ATM-HSW/CombiSensor/README.md

# CombiSensor
MCU plattform + Sensor module for several environmental sensors + LoRaWAN
