ATM-HSW/CombiSensor/Hardware/SensorBoard/SensorsOnly.v7.brd.pdf

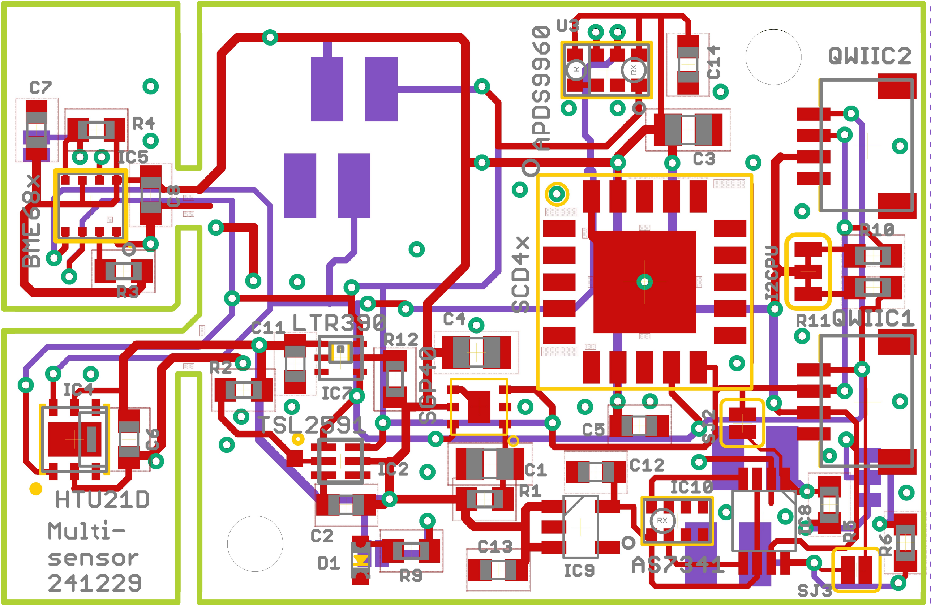
[picture p1: figure]

08.02.2025 20:13 f=5.74 C:\Clouds\CS2_CAD\eagle\RaumSensor\SensorsOnly\v7\SensorsOnly.v7.brd
