ATM-HSW/CombiSensor/Hardware/BaseBoard-Feather/feather.v4.brd.pdf

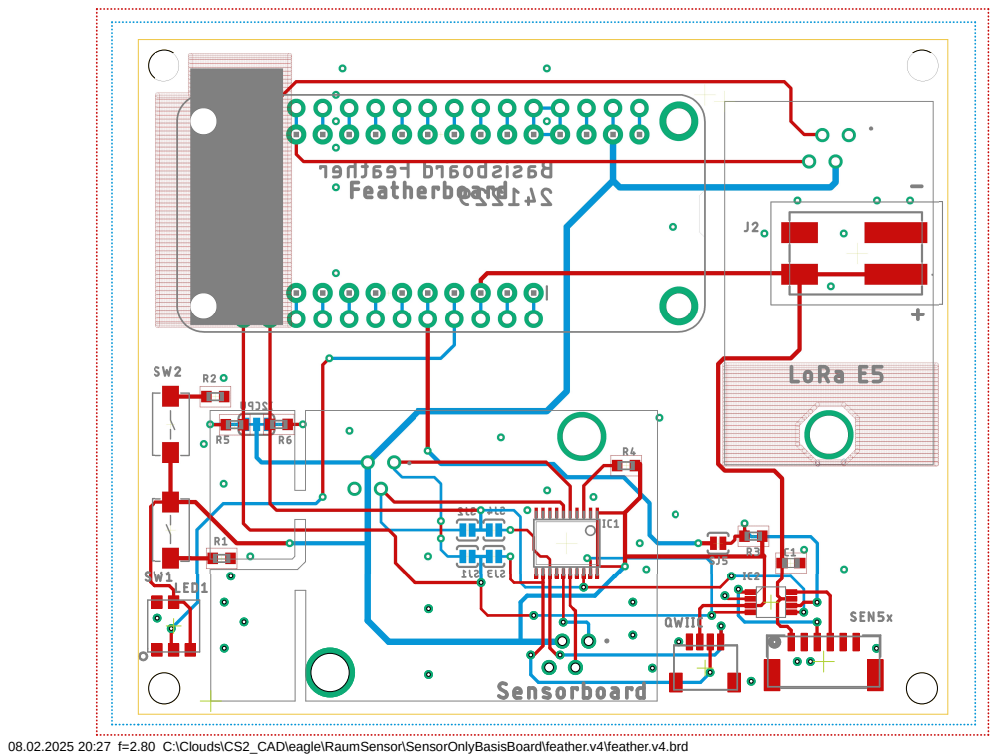
[picture p2: page 1]

08.02.2025 20:27 f=2.80 C:\Clouds\CS2_CAD\eagle\RaumSensor\SensorOnlyBasisBoard\feather.v4\feather.v4.brd
