ATM-HSW/CombiSensor/Hardware/BaseBoard-Feather/feather.v4.sch.pdf

# SensorBoard Feather

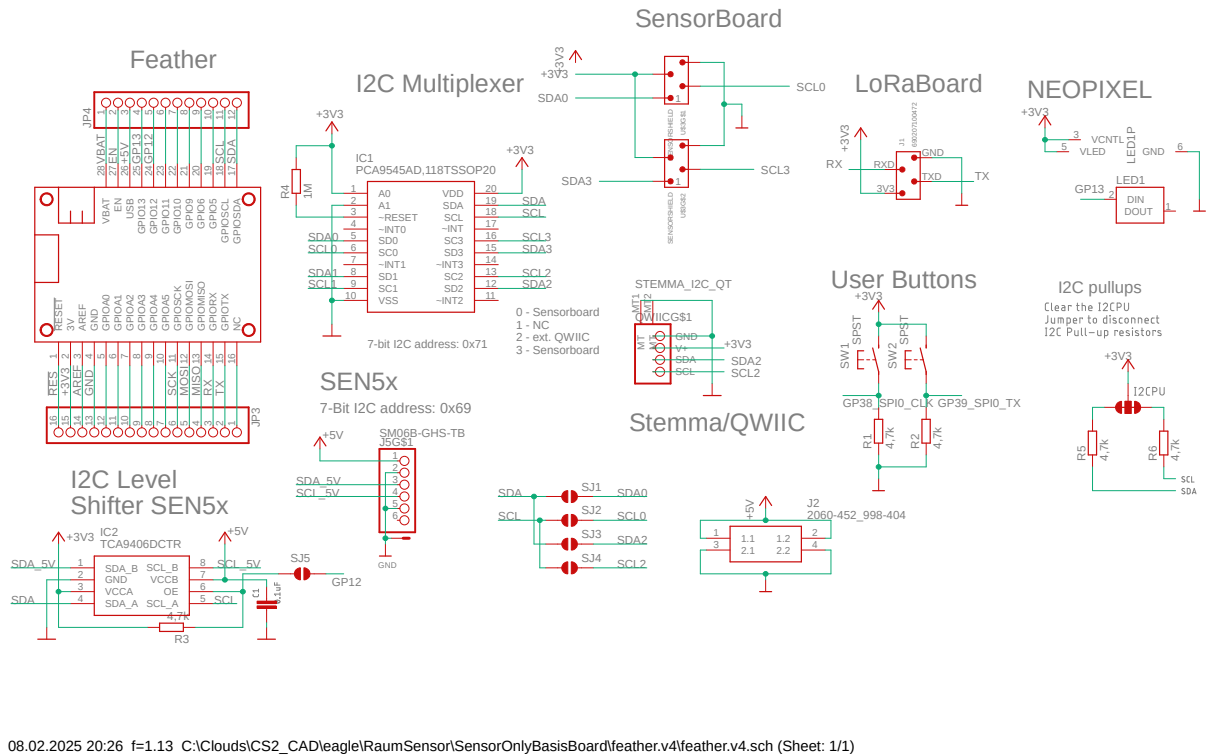
[picture p3: page 1]
User Buttons; Stemma/QWIIC; 7-bit I2C address: 0x71; I2C Multiplexer; 0 - Sensorboard 1 - NC 2 - ext. QWIIC 3 - Sensorboard; NEOPIXEL; I2C pullups; LoRaBoard; SEN5x; I2C Level Shifter SEN5x; 7-Bit I2C address: 0x69; +3V3 SPST; SPST 4,7k; PCA9545AD,118TSSOP20 1M; +3V3 ⁶⁹⁰²⁰⁷¹⁰⁰⁴⁷² SENSORSHIELD SENSORSHIELD +3V³; SM06B-GHS-TB GND +5V; TCA9406DCTR; GND V+ SDA SCL; DIN 2; DOUT; LED1; VLED 5; GND 6 VCNTL 3; LED¹P SW¹; SW² R¹; A0 1 A1 2 ~RESET 3 ~INT0 4 SD0 5 SC0 6 ~INT1 7 SD1 8 SC1 9; VSS 10; ~INT2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

9 GPIOA5 10 GPIOSCK 11 GPIOMOSI 12 GPIOMISO 13 GPIORX 14 GPIOTX 15 NC 16 GPIOSDA 17 GPIOSCL 18 GPIO5 19 GPIO9 21 GPIO6 20 GPIO10 22 GPIO11 23 GPIO12 24 GPIO13 25 EN 27 USB 26 VBAT 28 16151413121110

STEMMA_I2C_QT
QWIICG$1 MT MT1 MT MT2

08.02.2025 20:26 f=1.13 C:\Clouds\CS2_CAD\eagle\RaumSensor\SensorOnlyBasisBoard\feather.v4\feather.v4.sch (Sheet: 1/1)
