ATM-HSW/CombiSensor/Hardware/BaseBoard-QTPy/QTPY.v3.brd.pdf

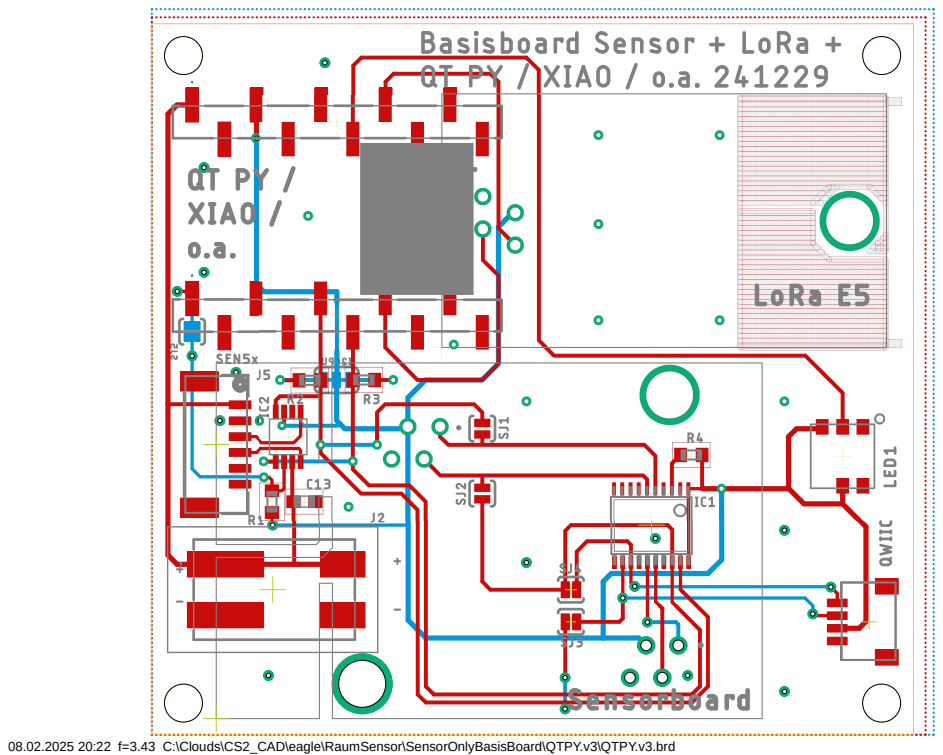
[picture p4: page 1]

08.02.2025 20:22 f=3.43 C:\Clouds\CS2_CAD\eagle\RaumSensor\SensorOnlyBasisBoard\QTPY.v3\QTPY.v3.brd
