ATM-HSW/CombiSensor/Hardware/BaseBoard-QTPy/QTPY.v3.sch.pdf

# QT PY

# I2C Level

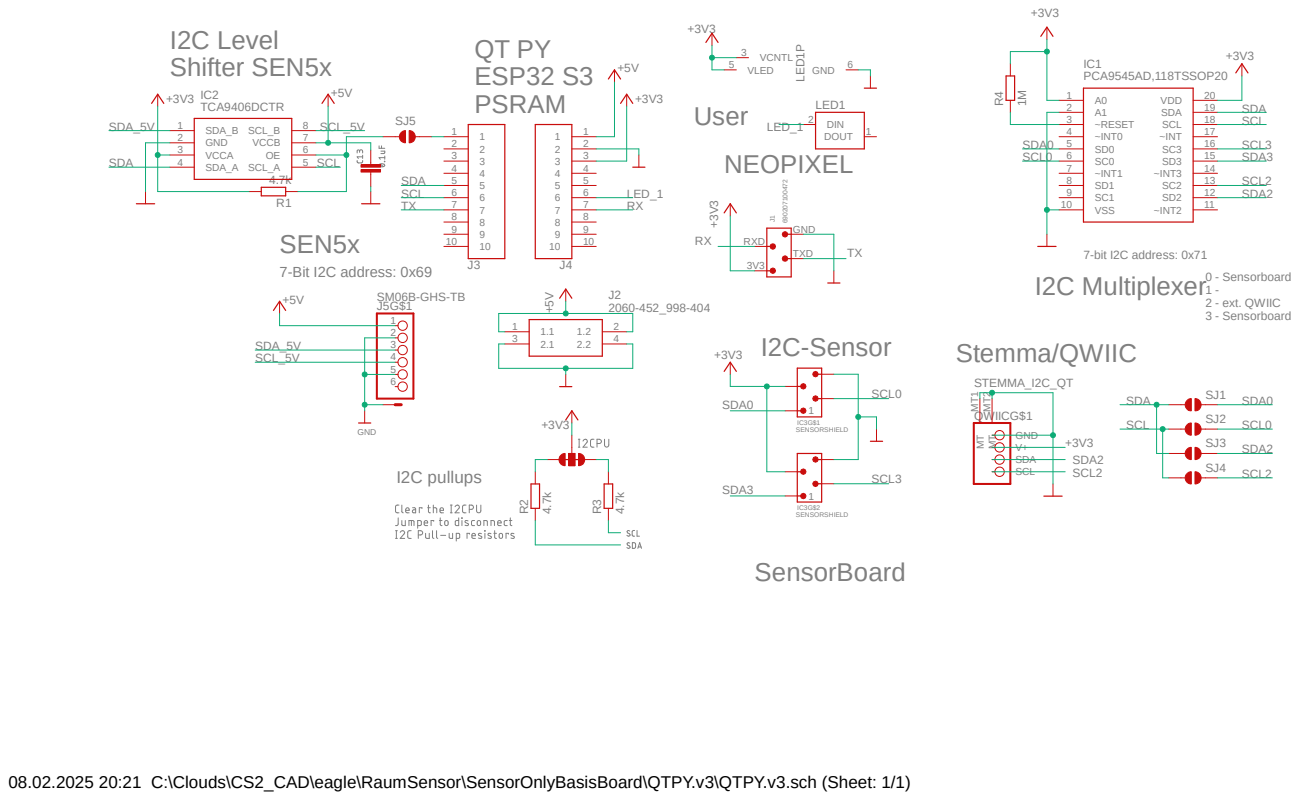
[picture p5: page 1]
SensorBoard; User; Stemma/QWIIC; ESP32 S3 PSRAM; 7-bit I2C address: 0x71 I2C Multiplexer⁰ ⁻ Sensorboard 1 - 2 - ext. QWIIC 3 - Sensorboard; NEOPIXEL; I2C pullups; I2C-Sensor; Shifter SEN5x; SEN5x; 7-Bit I2C address: 0x69; PCA9545AD,118TSSOP20 1M 4.7k; SENSORSHIELD; SENSORSHIELD +3V3 ⁺³V³ +5V; SM06B-GHS-TB; GND +5V; TCA9406DCTR; GND V+ SDA; DIN 2; DOUT; 1 LED1; VLED 5; GND 6; VCNTL 3; LED¹P; A0 1 A1 2 ~RESET 3 ~INT0 4 SD0 5 SC0 6 ~INT1 7 SD1 8 SC1 9; VSS 10; ~INT2; 13 ~INT3; 16 ~INT; 17 SCL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

STEMMA_I2C_QT
SCL QWIICG$1 MT MT1 MT MT2

08.02.2025 20:21 C:\Clouds\CS2_CAD\eagle\RaumSensor\SensorOnlyBasisBoard\QTPY.v3\QTPY.v3.sch (Sheet: 1/1)
