ATM-HSW/CombiSensor/Hardware/BaseBoard-WaveshareESP32S2-LCD/waveshare.v4.brd.pdf

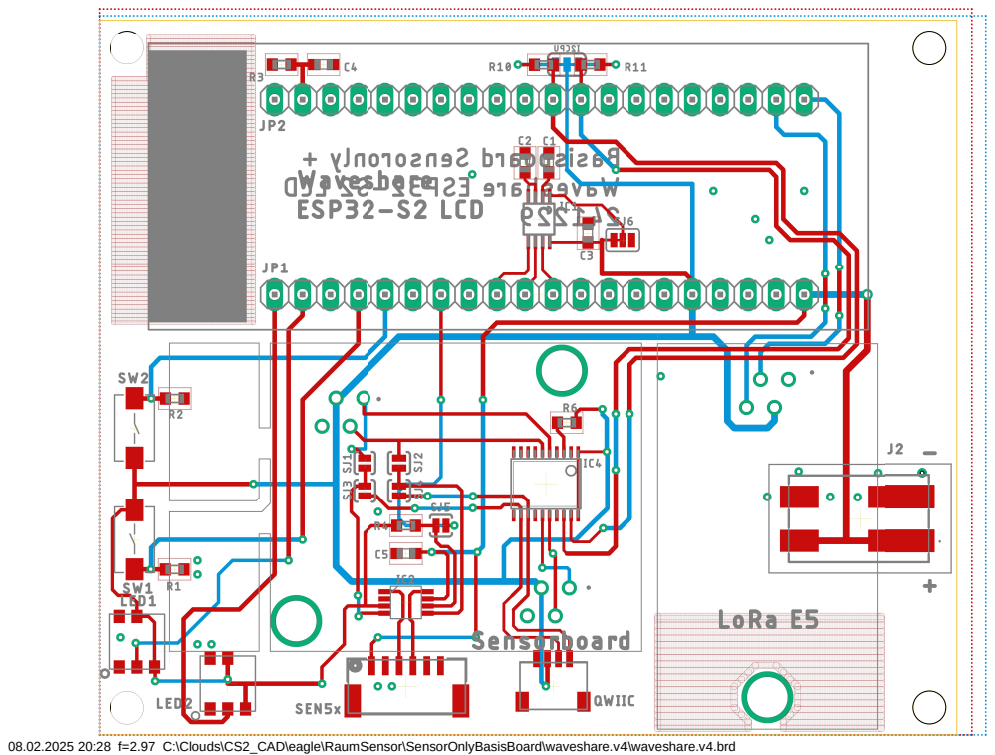
[picture p6: page 1]

08.02.2025 20:28 f=2.97 C:\Clouds\CS2_CAD\eagle\RaumSensor\SensorOnlyBasisBoard\waveshare.v4\waveshare.v4.brd
