ATM-HSW/CombiSensor/Hardware/BaseBoard-WaveshareESP32S2-LCD/waveshare.v4.sch.pdf

# I2C Multiplexer

# SEN5x

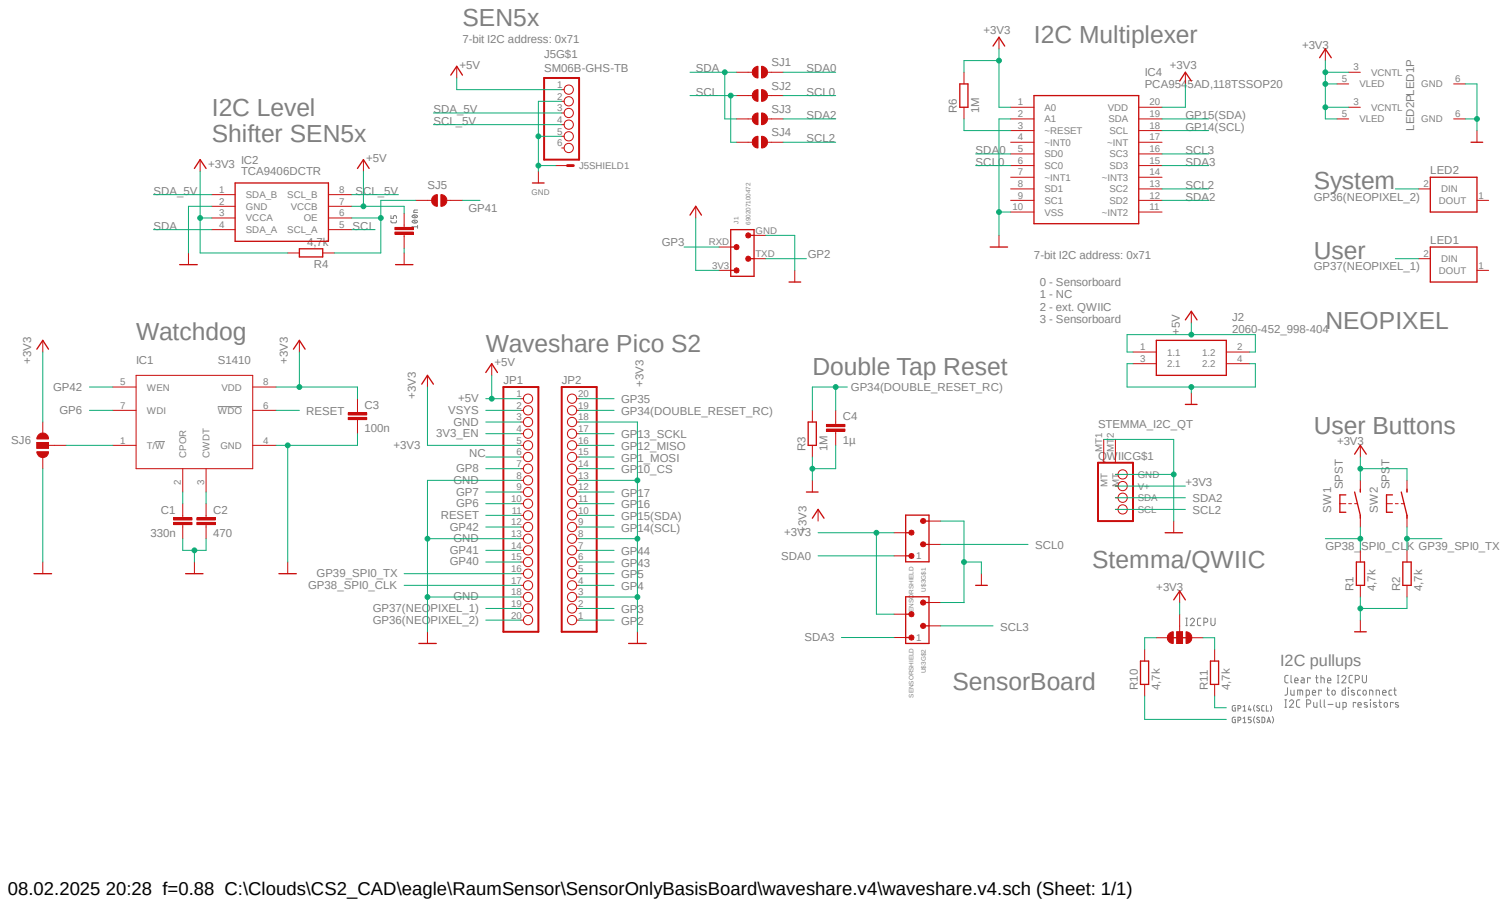
[picture p7: page 1]

08.02.2025 20:28 f=0.88 C:\Clouds\CS2_CAD\eagle\RaumSensor\SensorOnlyBasisBoard\waveshare.v4\waveshare.v4.sch (Sheet: 1/1)
