ATM-HSW/CombiSensor/Hardware/SensorBoard/SensorsOnly.v7.sch.pdf

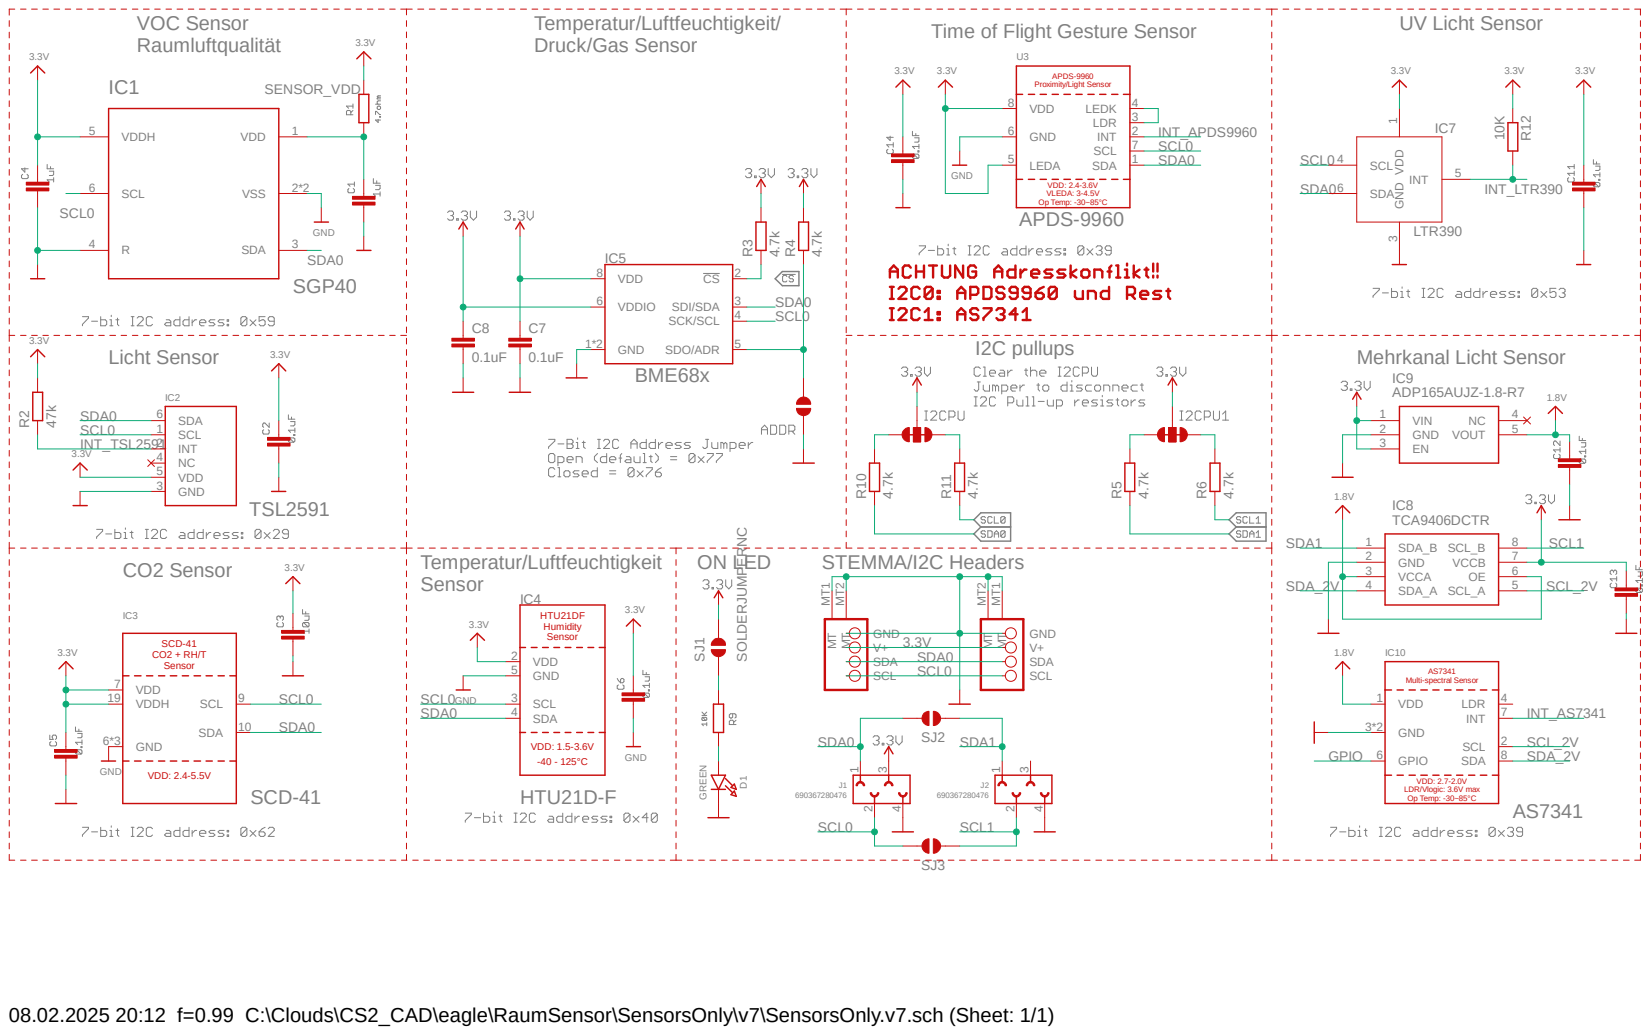
[picture p8: page 1]

Time of Flight Gesture Sensor

08.02.2025 20:12 f=0.99 C:\Clouds\CS2_CAD\eagle\RaumSensor\SensorsOnly\v7\SensorsOnly.v7.sch (Sheet: 1/1)
