ATM-HSW/CombiSensor/Hardware/SensorBoard/SensorsOnly.v6.brd.pdf

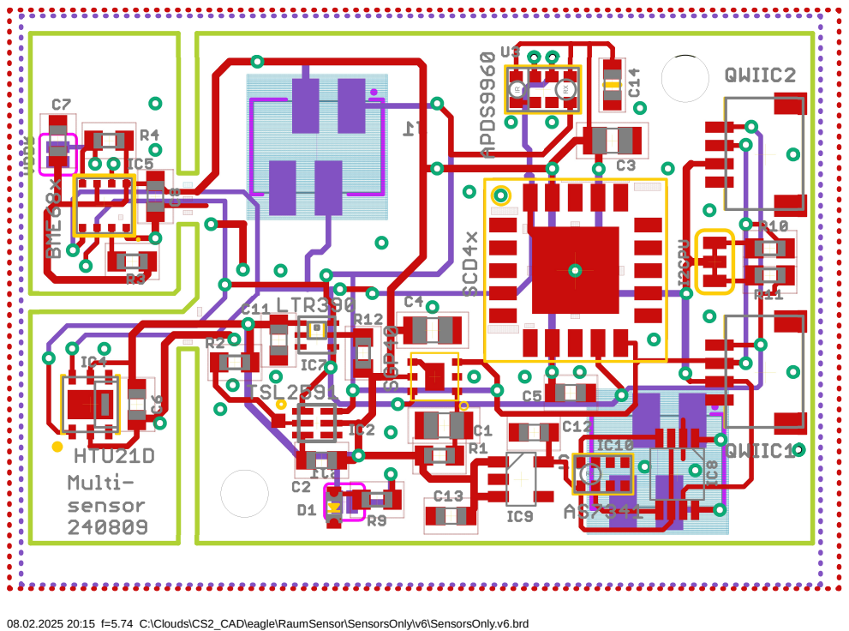
[picture p9: page 1]

08.02.2025 20:15 f=5.74 C:\Clouds\CS2_CAD\eagle\RaumSensor\SensorsOnly\v6\SensorsOnly.v6.brd
