ATM-HSW/CombiSensor/Hardware/SensorBoard/SensorsOnly.v6.sch.pdf

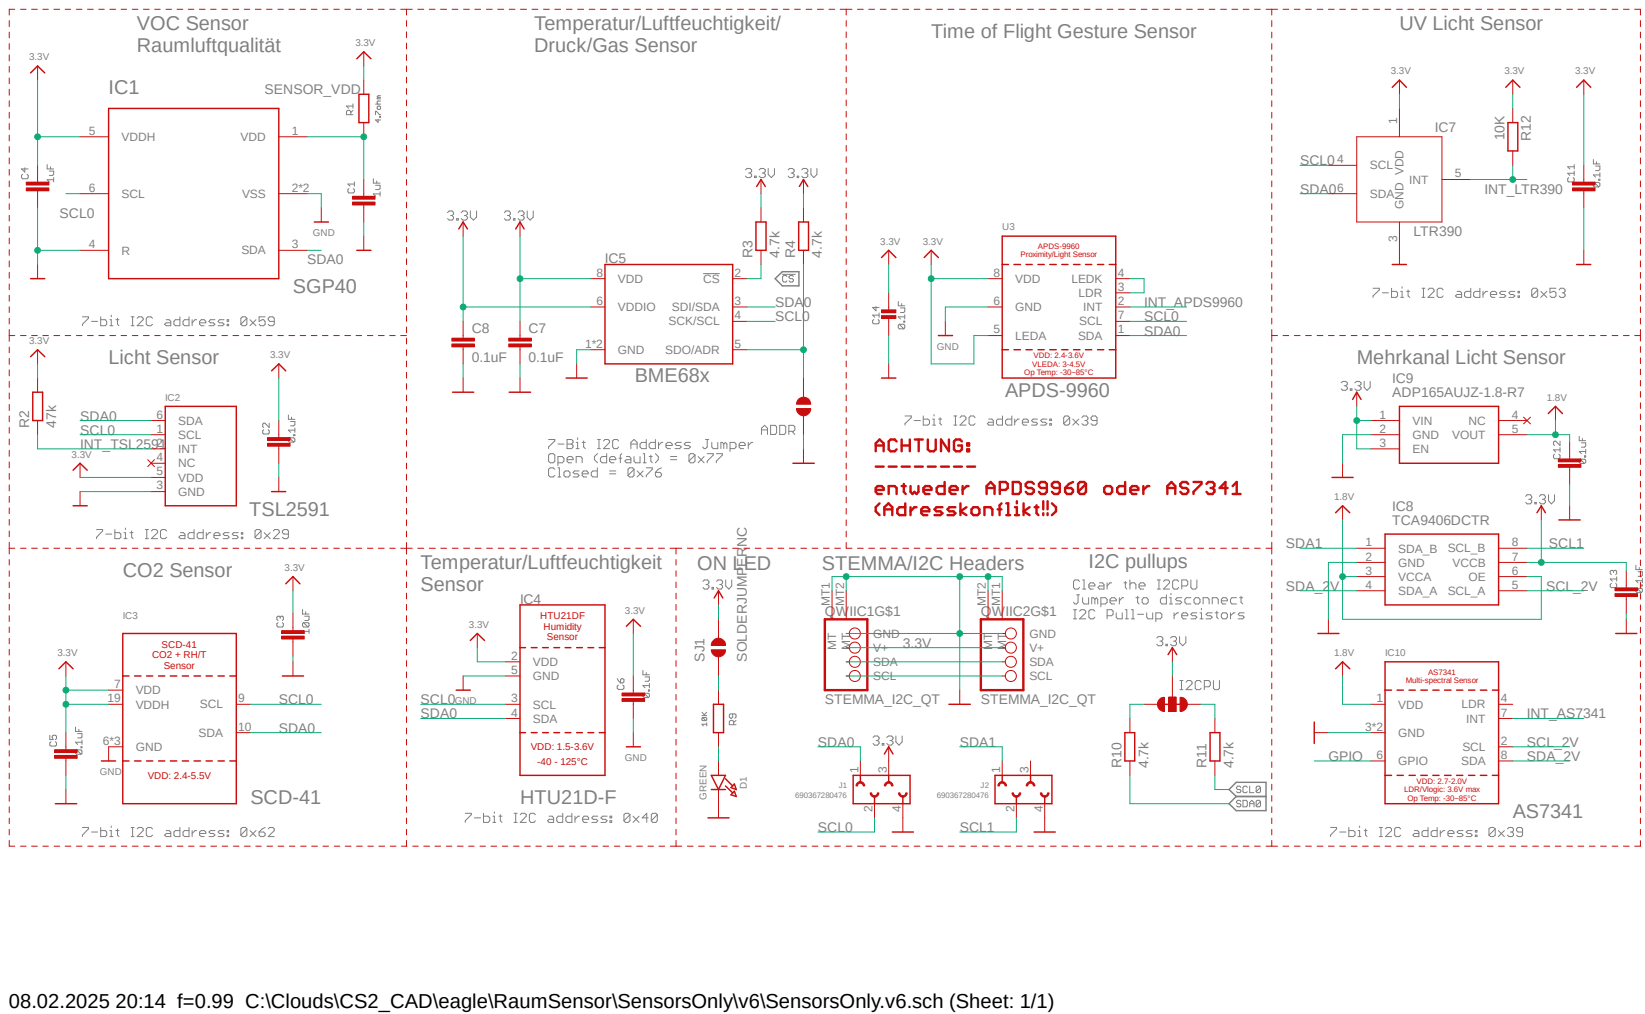
[picture p10: page 1]

Time of Flight Gesture Sensor

08.02.2025 20:14 f=0.99 C:\Clouds\CS2_CAD\eagle\RaumSensor\SensorsOnly\v6\SensorsOnly.v6.sch (Sheet: 1/1)
