ATM-HSW/CombiSensor/Hardware/SensorBoard/SensorsOnly.v6.brd

## EAGLE design Hardware/SensorBoard/SensorsOnly.v6.brd (2025-03-10, an earlier design)

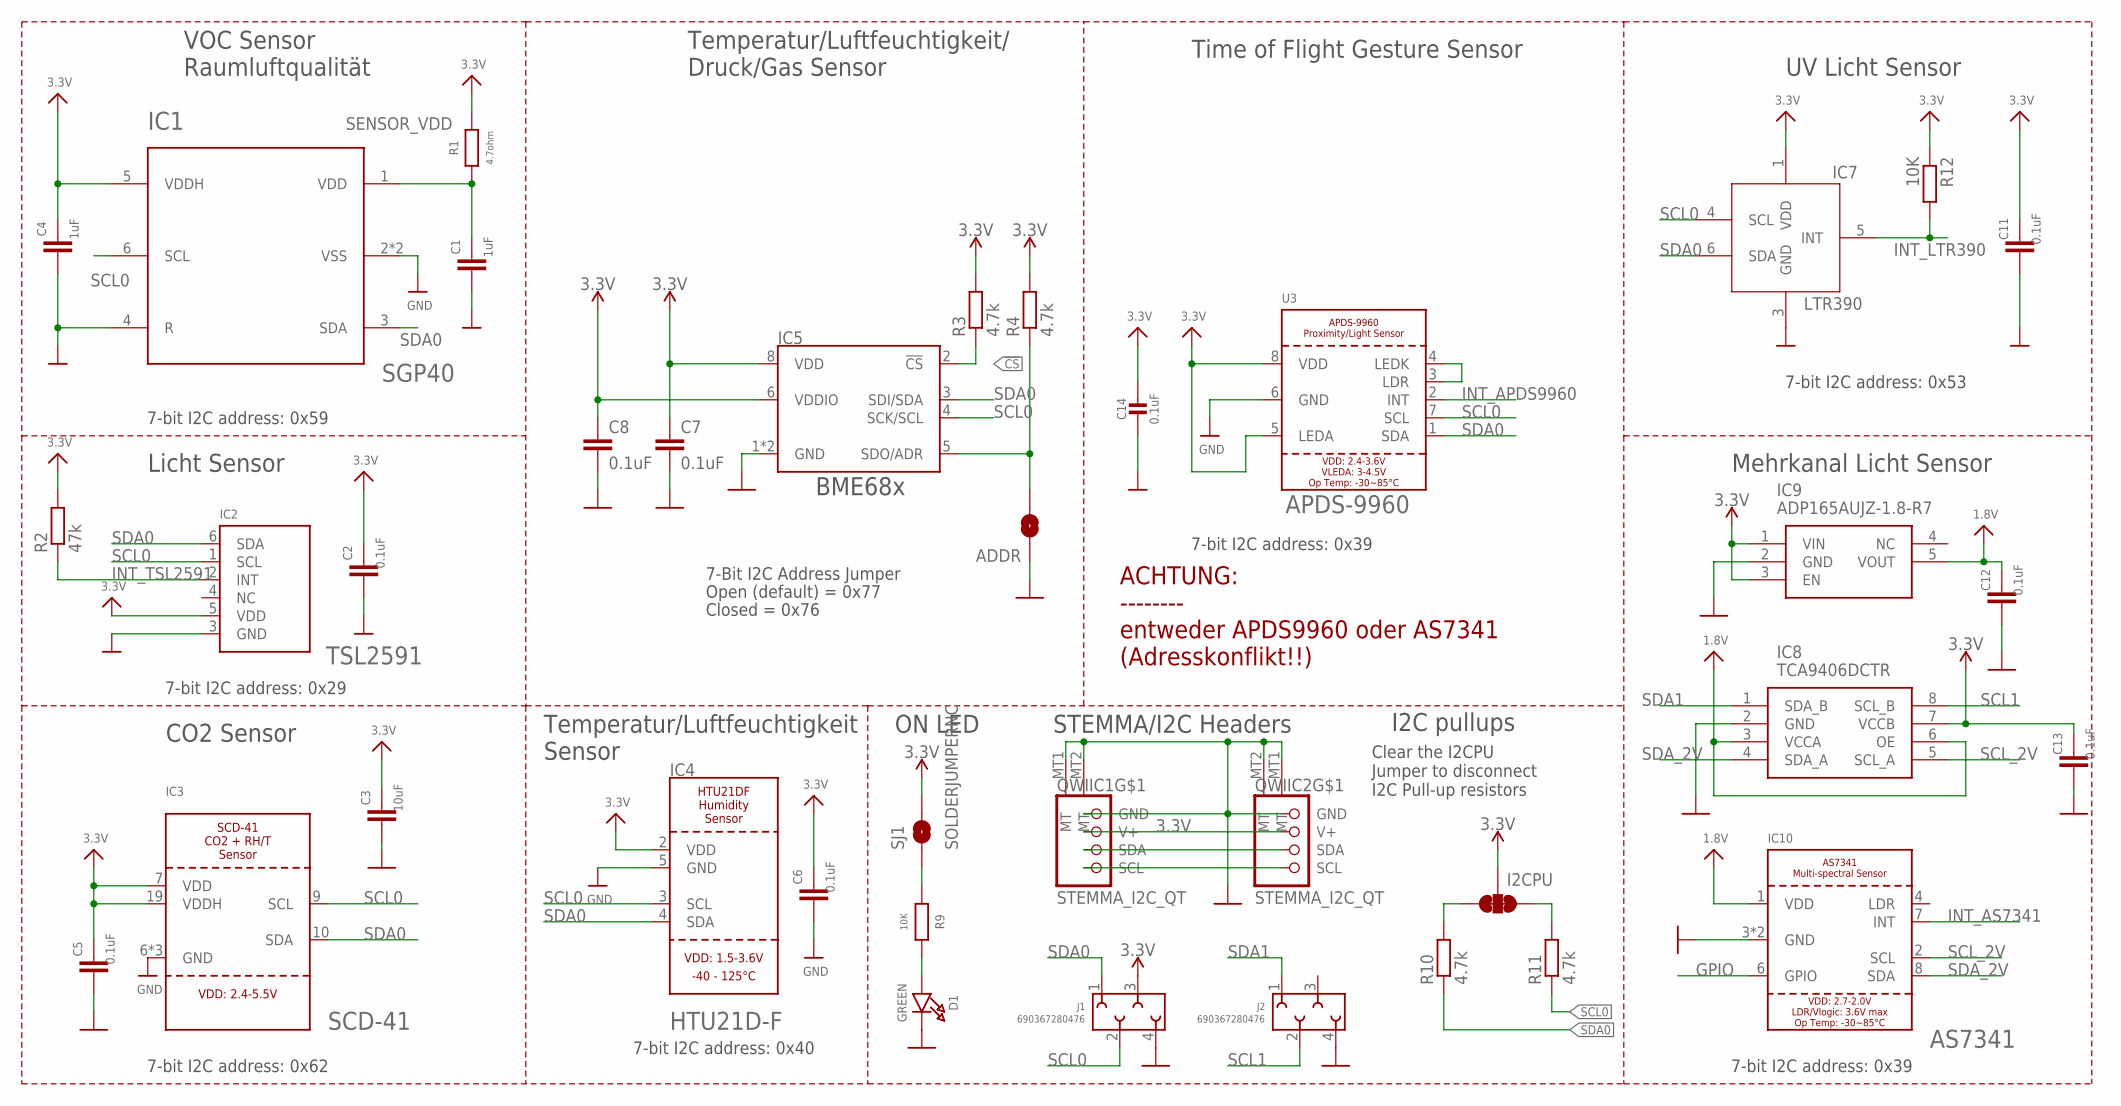
[picture p11: schematic SensorsOnly.v6.sch]

Parts:
ADDR: JUMPER-SMT_2_NO_SILK; SMT-JUMPER_2_NO_SILK
C1, C4: 1uF; C0805
C2, C5, C6, C7, C8, C11, C12, C13: 0.1uF; C0603
C3: 10uF; C0805
C14: 0.1uF; 0603-NO
D1: GREEN; CHIPLED_0603_NOOUTLINE
I2CPU: I2C PU; SMT-JUMPER_3_2-NC_TRACE_SILK
IC1: SGP40; SGP30
IC2: TSL2591; DFN6_TAOS
IC3: SCD-41; SCD41
IC4: HTU21D-F; HTU21DF
IC5: BME680 Air Quality Sensor; LGA3.0X3.0
IC7: LTR390
IC8: TCA9406DCTR; SOP65P400X130-8N
IC9: ADP165AUJZ-1.8-R7; SOT95P280X100-5N
IC10: AS7341
J1, J2: 690367280476
QWIIC1, QWIIC2: STEMMA_I2C_QT; JST_SH4
R1: 4.7ohm; R0603
R2: 47k; R0603
R3, R4, R10, R11: 4.7k; R0603
R9, R12: 10K; R0603
SJ1: SOLDERJUMPERNC; SJ_2S
U3: APDS-9960

Connections:
1.8V: C12.1, IC8.3 (VCCA), IC8.6 (OE), IC9.5 (VOUT), IC10.1 (VDD)
3.3V: C2.1, C3.1, C4.1, C5.1, C6.1, C7.1, C8.1, C11.1, C13.1, C14.1, I2CPU.2, IC1.5 (VDDH), IC2.5 (VDD), IC3.7 (VDD), IC3.19 (VDDH), IC4.2 (VDD), IC5.6 (VDDIO), IC5.8 (VDD), IC7.1 (VDD), IC8.7 (VCCB), IC9.1 (VIN), IC9.3 (EN), J1.3, QWIIC1.2 (V+), QWIIC2.2 (V+), R1.2, R2.2, R3.2, R4.2, R12.1, SJ1.2, U3.5 (LEDA), U3.8 (VDD)
!CS: IC5.2 (!CS), R3.1
GND: ADDR.1, C1.2, C2.2, C3.2, C4.2, C5.2, C6.2, C7.2, C8.2, C11.2, C12.2, C13.2, C14.2, D1.C, IC1.2 (VSS), IC1.4 (R), IC1.P$7 (VSS), IC2.3 (GND), IC3.6 (GND), IC3.20 (GND), IC3.P$1 (GND), IC4.5 (GND), IC5.1 (GND), IC5.7 (GND), IC7.3 (GND), IC8.2 (GND), IC9.2 (GND), IC10.3 (GND), IC10.5 (GND), J1.4, J2.4, QWIIC1.1 (GND), QWIIC1.MT1 (MT), QWIIC1.MT2 (MT), QWIIC2.1 (GND), QWIIC2.MT1 (MT), QWIIC2.MT2 (MT), U3.6 (GND)
GPIO: IC10.6 (GPIO)
INT_APDS9960: U3.2 (INT)
INT_AS7341: IC10.7 (INT)
INT_LTR390: IC7.5 (INT), R12.2
INT_TSL2591: IC2.2 (INT), R2.1
unnamed: D1.A, R9.2
unnamed: U3.3 (LDR), U3.4 (LEDK)
unnamed: R9.1, SJ1.1
unnamed: I2CPU.3, R10.2
unnamed: I2CPU.1, R11.2
SCL0: IC1.6 (SCL), IC2.1 (SCL), IC3.9 (SCL), IC4.3 (SCL), IC5.4 (SCK/SCL), IC7.4 (SCL), J1.2, QWIIC1.4 (SCL), QWIIC2.4 (SCL), R11.1, U3.7 (SCL)
SCL1: IC8.8 (SCL_B), J2.2
SCL_2V: IC8.5 (SCL_A), IC10.2 (SCL)
SDA0: IC1.3 (SDA), IC2.6 (SDA), IC3.10 (SDA), IC4.4 (SDA), IC5.3 (SDI/SDA), IC7.6 (SDA), J1.1, QWIIC1.3 (SDA), QWIIC2.3 (SDA), R10.1, U3.1 (SDA)
SDA1: IC8.1 (SDA_B), J2.1
SDA_2V: IC8.4 (SDA_A), IC10.8 (SDA)
SDO/ADR: ADDR.2, IC5.5 (SDO/ADR), R4.1
SENSOR_VDD: C1.1, IC1.1 (VDD), R1.1

Notes on the sheet:
STEMMA/I2C Headers
ON LED
7-Bit I2C Address Jumper
Open (default) = 0x77
Closed = 0x76
Clear the I2CPU Jumper to disconnect I2C Pull-up resistors
7-bit I2C address: 0x39
Time of Flight Gesture Sensor
I2C pullups
7-bit I2C address: 0x40
7-bit I2C address: 0x62
7-bit I2C address: 0x29
7-bit I2C address: 0x59
7-bit I2C address: 0x53
ACHTUNG: -------- entweder APDS9960 oder AS7341 (Adresskonflikt!!)
VOC Sensor Raumluftqualität
Temperatur/Luftfeuchtigkeit/ Druck/Gas Sensor
UV Licht Sensor
Mehrkanal Licht Sensor
Temperatur/Luftfeuchtigkeit Sensor
CO2 Sensor
Licht Sensor
BME68x

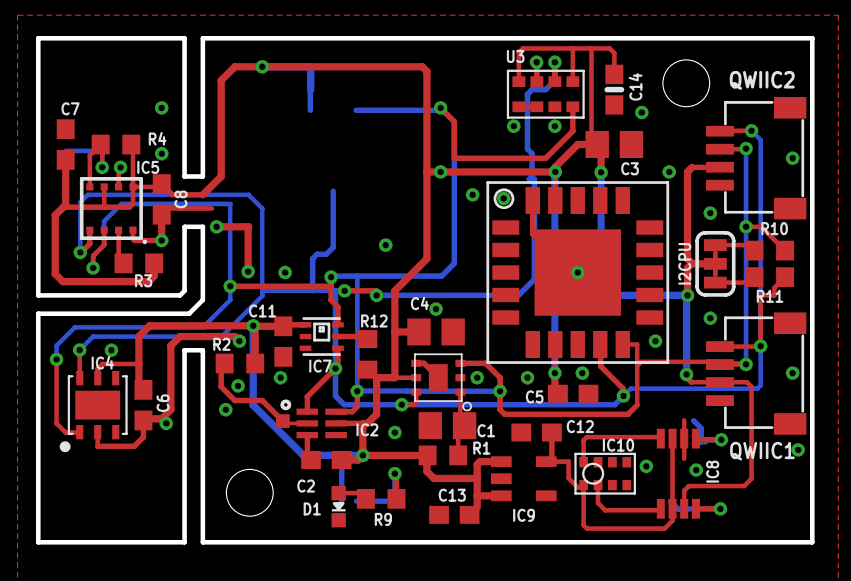
[picture p12: board SensorsOnly.v6.brd from above]

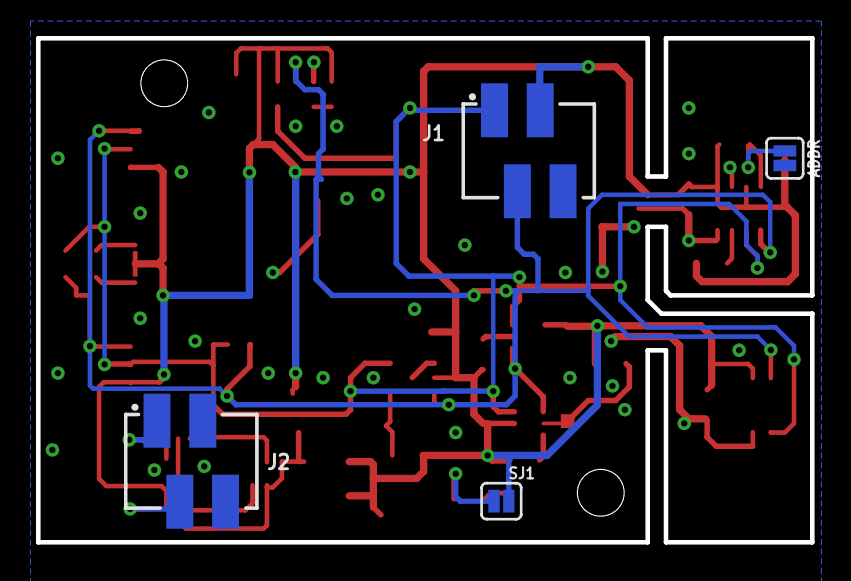
[picture p13: board SensorsOnly.v6.brd from below]

Board: 2 copper layers, 43.0 x 28.0 mm, 38 parts (4 on the bottom side), 19 nets.
