ATM-HSW/CombiSensor/Hardware/BaseBoard-QTPy/QTPY.v3.brd

## EAGLE design Hardware/BaseBoard-QTPy/QTPY.v3.brd (2025-03-10)

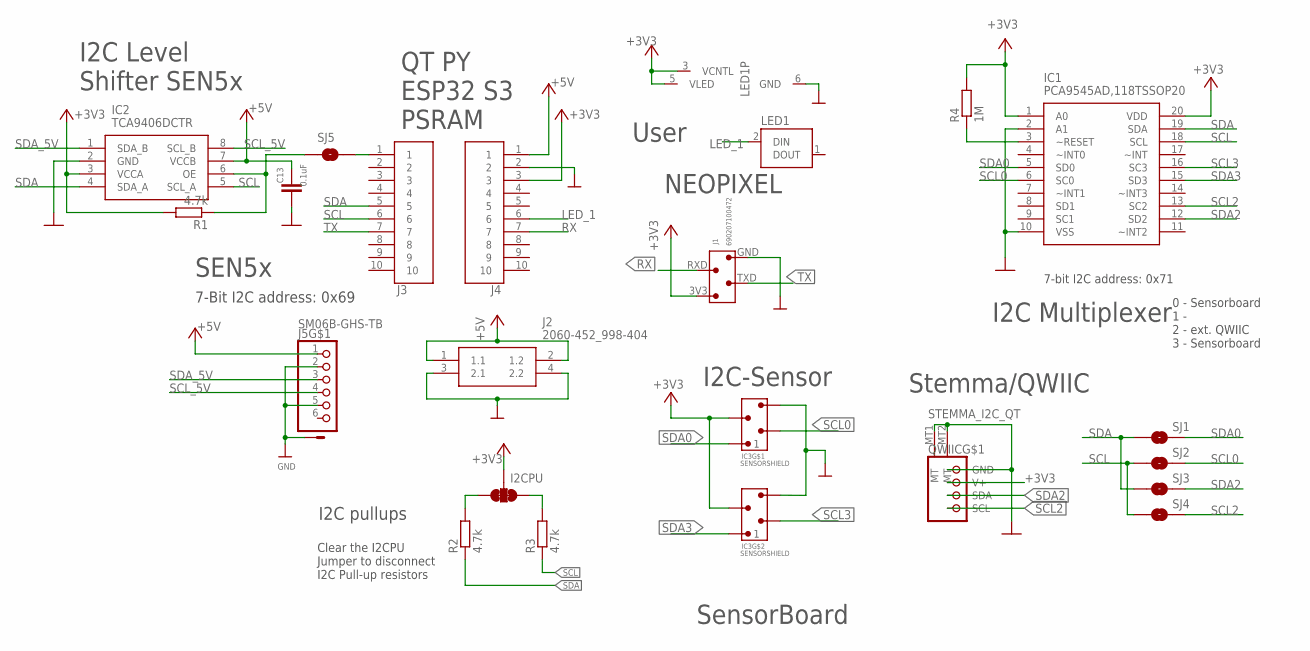
[picture p14: schematic QTPY.v3.sch]

Parts:
C13: 0.1uF; C0603
I2CPU: I2C PU; SMT-JUMPER_3_2-NC_TRACE_SILK
IC1: PCA9545AD,118TSSOP20; TSSOP20
IC2: TCA9406DCTR; SOP65P400X130-8N
IC3: SENSORSHIELD
J1: 690207100472; LORASHIELD
J2: 2060-452_998-404; 2060452998404
J3, J4: BG125-10-A-1-1-0440-N-D; BG12510A110440ND
J5: SM06B-GHS-TB; JST-PH-06-SMD
LED1: WS2812WS2812; WS2812
QWIIC: STEMMA_I2C_QT; JST_SH4
R1, R2, R3: 4.7k; R0603
R4: 1M; R0603
SJ1, SJ2, SJ3, SJ4, SJ5: SOLDERJUMPERNO; SJ_2S-NO

Connections:
+3V3: I2CPU.2, IC1.1 (A0), IC1.20 (VDD), IC2.3 (VCCA), IC3.3V3_1 (3), IC3.3V3_2 (3), J1.3V3 (4), J3.3, LED1.3 (VCNTL), LED1.5 (VLED), QWIIC.2 (V+), R1.2, R4.2
+5V: C13.1, IC2.7 (VCCB), J2.1 (1.1), J2.2 (1.2), J3.1, J5.1
GND: C13.2, IC1.2 (A1), IC1.10 (VSS), IC2.2 (GND), IC3.GND_1 (4), IC3.GND_2 (4), J1.GND (1), J2.3 (2.1), J2.4 (2.2), J3.2, J5.2, J5.5, J5.7 (S), J5.8 (S), LED1.6 (GND), QWIIC.1 (GND), QWIIC.MT1 (MT), QWIIC.MT2 (MT)
LED_1: J3.6, LED1.2 (DIN)
unnamed: IC2.6 (OE), R1.1, SJ5.1
unnamed: J4.1, SJ5.2
unnamed: IC1.3 (~RESET), R4.1
unnamed: I2CPU.3, R2.2
unnamed: I2CPU.1, R3.2
RX: J1.RXD (2), J3.7
SCL: IC1.18 (SCL), IC2.5 (SCL_A), J4.6, R3.1, SJ2.1, SJ4.1
SCL0: IC1.6 (SC0), IC3.SCL0 (2), SJ2.2
SCL2: IC1.13 (SC2), QWIIC.4 (SCL), SJ4.2
SCL3: IC1.16 (SC3), IC3.SCL1 (2)
SCL_5V: IC2.8 (SCL_B), J5.4
SDA: IC1.19 (SDA), IC2.4 (SDA_A), J4.5, R2.1, SJ1.1, SJ3.1
SDA0: IC1.5 (SD0), IC3.SDA0 (1), SJ1.2
SDA2: IC1.12 (SD2), QWIIC.3 (SDA), SJ3.2
SDA3: IC1.15 (SD3), IC3.SDA1 (1)
SDA_5V: IC2.1 (SDA_B), J5.3
TX: J1.TXD (3), J4.7

Notes on the sheet:
SensorBoard
User
Stemma/QWIIC
QT PY ESP32 S3 PSRAM
7-bit I2C address: 0x71
I2C Multiplexer
0 - Sensorboard 1 - 2 - ext. QWIIC 3 - Sensorboard
NEOPIXEL
Clear the I2CPU Jumper to disconnect I2C Pull-up resistors
I2C pullups
I2C-Sensor
I2C Level Shifter SEN5x
SEN5x
7-Bit I2C address: 0x69

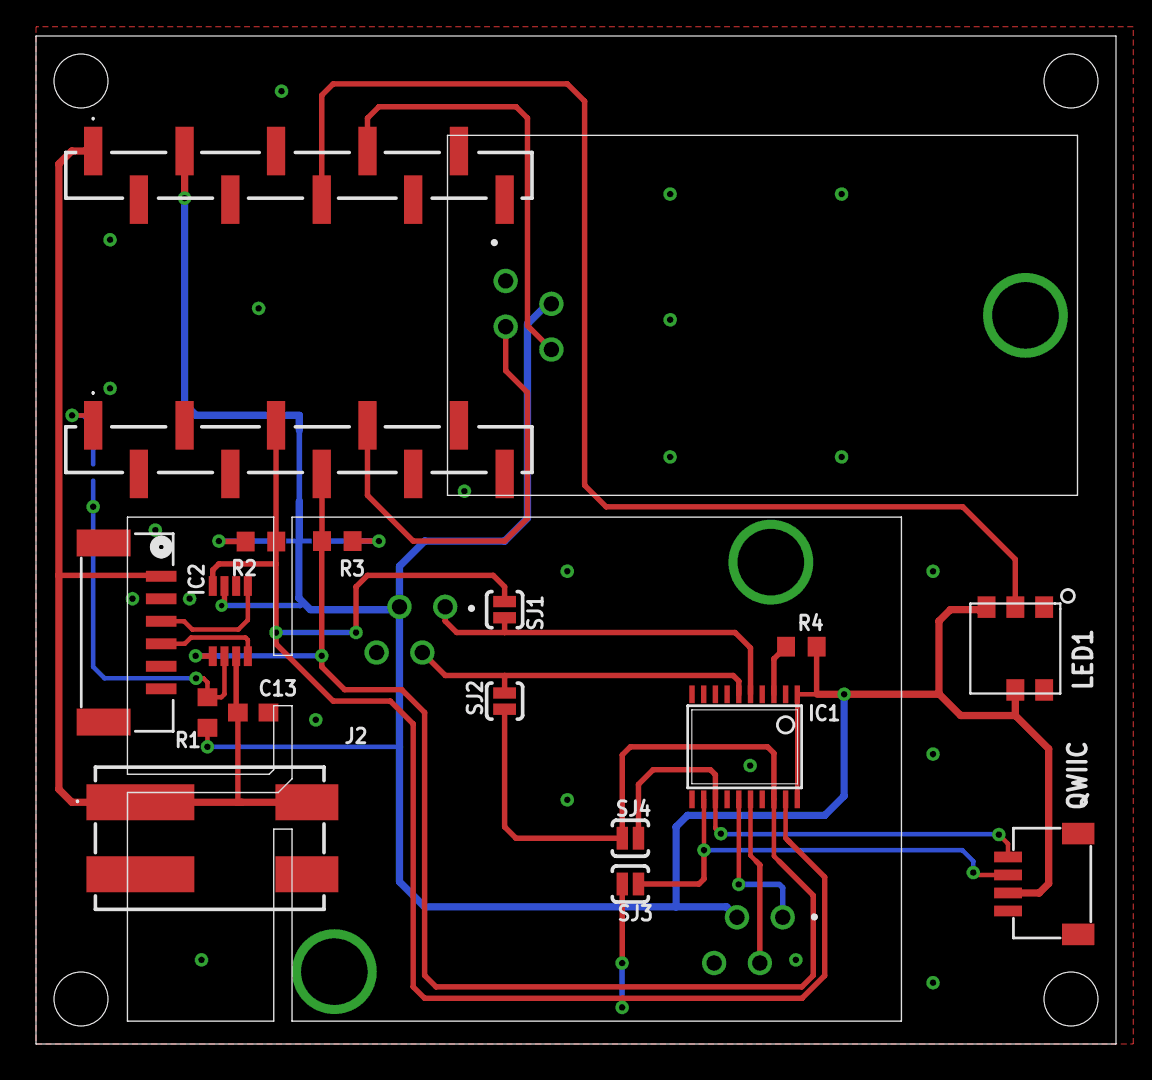
[picture p15: board QTPY.v3.brd from above]

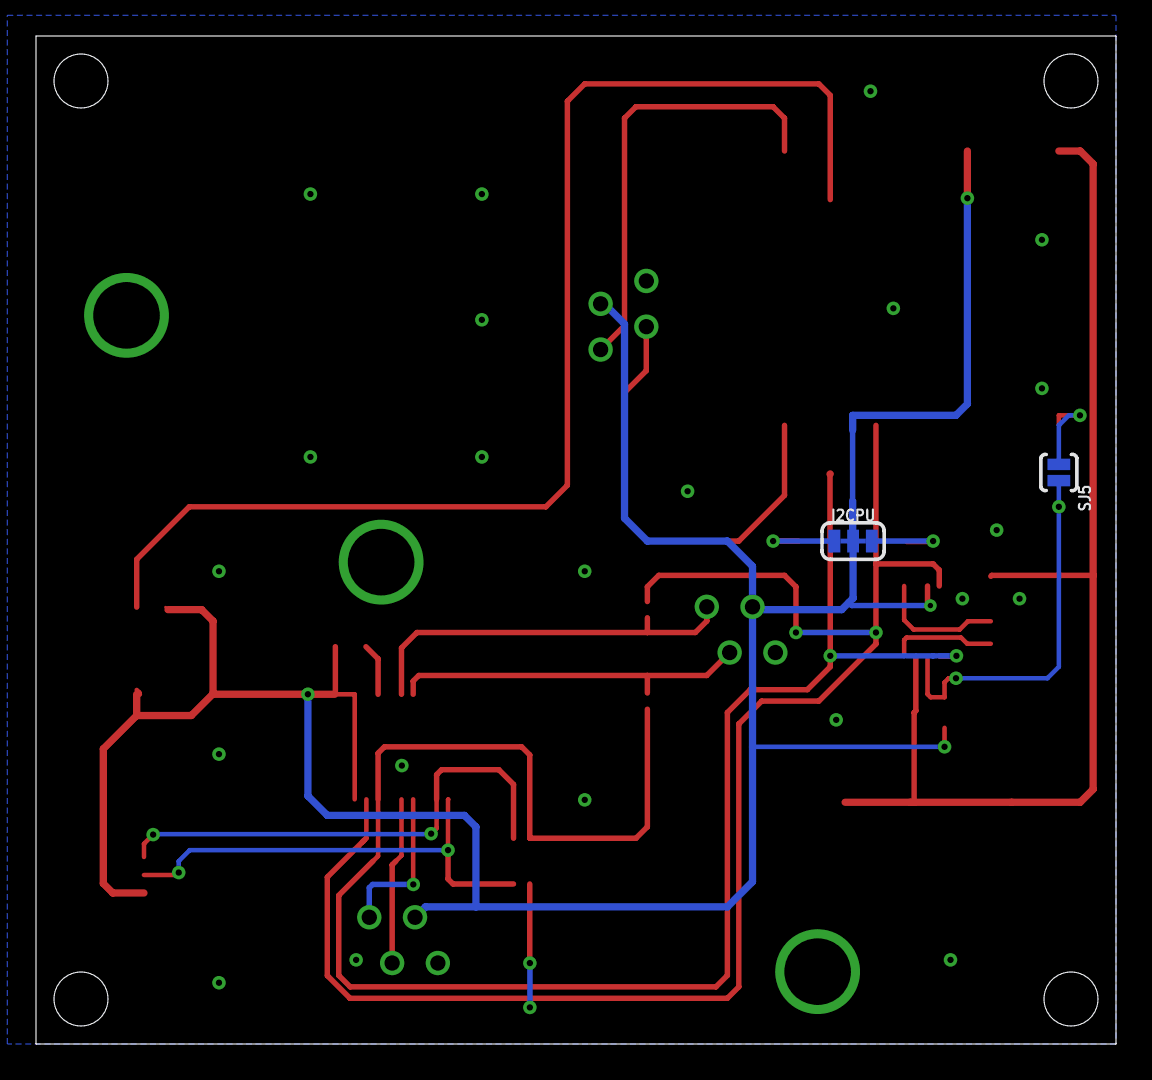
[picture p16: board QTPY.v3.brd from below]

Board: 2 copper layers, 60.0 x 56.0 mm, 21 parts (2 on the bottom side), 21 nets.
