ATM-HSW/CombiSensor/Hardware/BaseBoard-Feather/feather.v4.brd

## EAGLE design Hardware/BaseBoard-Feather/feather.v4.brd (2025-03-10)

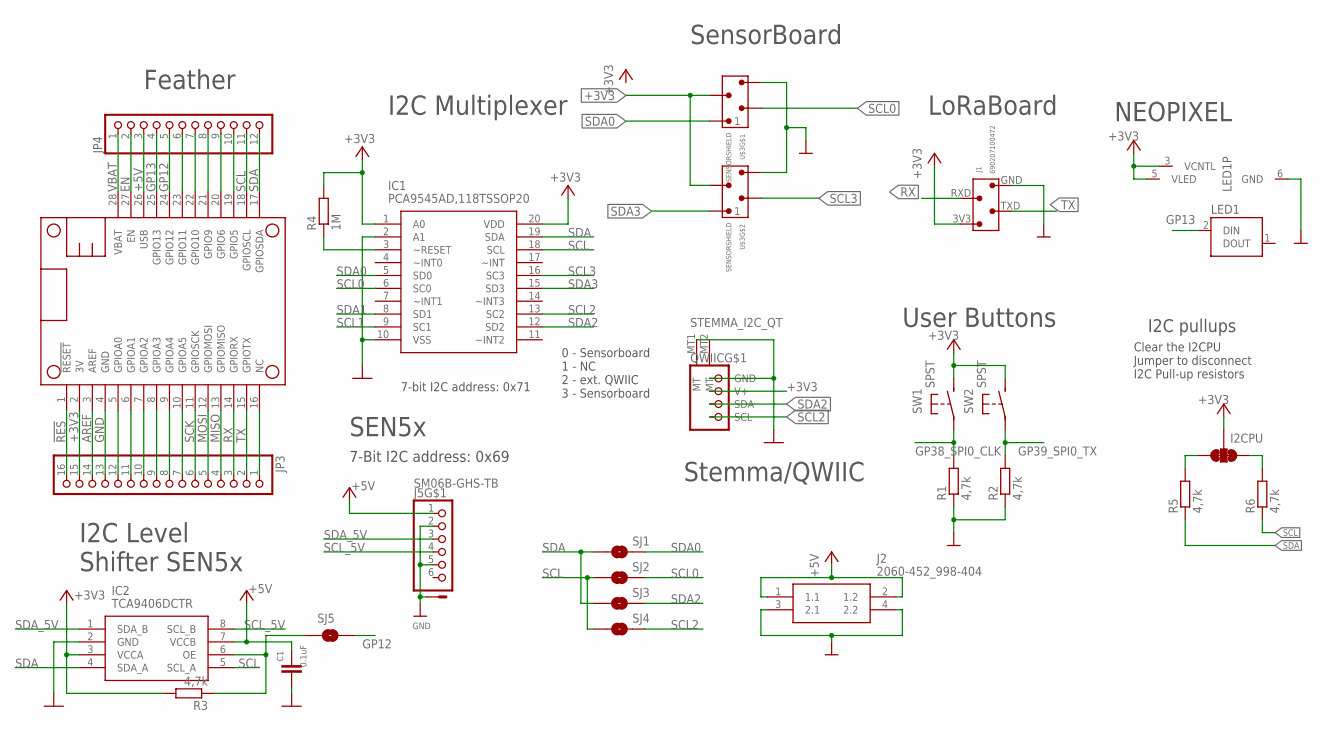
[picture p17: schematic feather.v4.sch]

Parts:
C1: 0.1uF; C0603
I2CPU: I2C PU; SMT-JUMPER_3_2-NC_TRACE_SILK
IC1: PCA9545AD,118TSSOP20; TSSOP20
IC2: TCA9406DCTR; SOP65P400X130-8N
J1: 690207100472; LORASHIELD
J2: 2060-452_998-404; 2060452998404
J5: SM06B-GHS-TB; JST-PH-06-SMD
JP3: HEADER-1X16_76MIL; 1X16_ROUND_76MIL
JP4: HEADER-1X1276MIL; 1X12_ROUND_76MIL
LED1: WS2812WS2812; WS2812
MS1: FEATHERWING_NODIM; FEATHERWING_DIM
QWIIC: STEMMA_I2C_QT; JST_SH4
R1, R2, R3, R5, R6: 4,7k; R0603
R4: 1M; R0603
SJ1, SJ2, SJ3, SJ4, SJ5: SOLDERJUMPERNO; SJ_2S-NO
SW1, SW2: SPST; DTSM-32S-B
U$3: SENSORSHIELD

Connections:
!RES: JP3.16, MS1.1 (!RESET)
+3V3: I2CPU.2, IC1.1 (A0), IC1.20 (VDD), IC2.3 (VCCA), J1.3V3 (4), JP3.15, LED1.3 (VCNTL), LED1.5 (VLED), MS1.2 (3V), QWIIC.2 (V+), R3.2, R4.2, SW1.P$2 (S), SW2.P$2 (S), U$3.3V3_1 (3), U$3.3V3_2 (3)
+5V: C1.1, IC2.7 (VCCB), J2.1 (1.1), J2.2 (1.2), J5.1, JP4.3, MS1.26 (USB)
AREF: JP3.14, MS1.3 (AREF)
EN: JP4.2, MS1.27 (EN)
GND: C1.2, IC1.2 (A1), IC1.10 (VSS), IC2.2 (GND), J1.GND (1), J2.3 (2.1), J2.4 (2.2), J5.2, J5.5, J5.7 (S), J5.8 (S), JP3.12, JP3.13, LED1.6 (GND), MS1.4 (GND), MS1.5 (GPIOA0), QWIIC.1 (GND), QWIIC.MT1 (MT), QWIIC.MT2 (MT), R1.1, R2.1, U$3.GND_1 (4), U$3.GND_2 (4)
GP12: JP4.5, MS1.24 (GPIO12), SJ5.2
GP13: JP4.4, LED1.2 (DIN), MS1.25 (GPIO13)
GP38_SPI0_CLK: R1.2, SW1.P$1
GP39_SPI0_TX: R2.2, SW2.P$1
MISO: JP3.4, MS1.13 (GPIOMISO)
MOSI: JP3.5, MS1.12 (GPIOMOSI)
unnamed: IC2.6 (OE), R3.1, SJ5.1
unnamed: JP3.1, MS1.16 (NC)
unnamed: IC1.3 (~RESET), R4.1
unnamed: I2CPU.3, R5.2
unnamed: I2CPU.1, R6.2
unnamed: JP3.7, MS1.10 (GPIOA5)
unnamed: JP3.8, MS1.9 (GPIOA4)
unnamed: JP3.9, MS1.8 (GPIOA3)
unnamed: JP3.10, MS1.7 (GPIOA2)
unnamed: JP3.11, MS1.6 (GPIOA1)
unnamed: JP4.6, MS1.23 (GPIO11)
unnamed: JP4.7, MS1.22 (GPIO10)
unnamed: JP4.8, MS1.21 (GPIO9)
unnamed: JP4.9, MS1.20 (GPIO6)
unnamed: JP4.10, MS1.19 (GPIO5)
RX: J1.RXD (2), JP3.3, MS1.14 (GPIORX)
SCK: JP3.6, MS1.11 (GPIOSCK)
SCL: IC1.18 (SCL), IC2.5 (SCL_A), JP4.11, MS1.18 (GPIOSCL), R6.1, SJ2.1, SJ4.1
SCL0: IC1.6 (SC0), SJ2.2, U$3.SCL0 (2)
SCL1: IC1.9 (SC1)
SCL2: IC1.13 (SC2), QWIIC.4 (SCL), SJ4.2
SCL3: IC1.16 (SC3), U$3.SCL1 (2)
SCL_5V: IC2.8 (SCL_B), J5.4
SDA: IC1.19 (SDA), IC2.4 (SDA_A), JP4.12, MS1.17 (GPIOSDA), R5.1, SJ1.1, SJ3.1
SDA0: IC1.5 (SD0), SJ1.2, U$3.SDA0 (1)
SDA1: IC1.8 (SD1)
SDA2: IC1.12 (SD2), QWIIC.3 (SDA), SJ3.2
SDA3: IC1.15 (SD3), U$3.SDA1 (1)
SDA_5V: IC2.1 (SDA_B), J5.3
TX: J1.TXD (3), JP3.2, MS1.15 (GPIOTX)
VBAT: JP4.1, MS1.28 (VBAT)

Notes on the sheet:
SensorBoard
User Buttons
Stemma/QWIIC
Feather
7-bit I2C address: 0x71
I2C Multiplexer
0 - Sensorboard 1 - NC 2 - ext. QWIIC 3 - Sensorboard
NEOPIXEL
Clear the I2CPU Jumper to disconnect I2C Pull-up resistors
I2C pullups
LoRaBoard
SEN5x
I2C Level Shifter SEN5x
7-Bit I2C address: 0x69

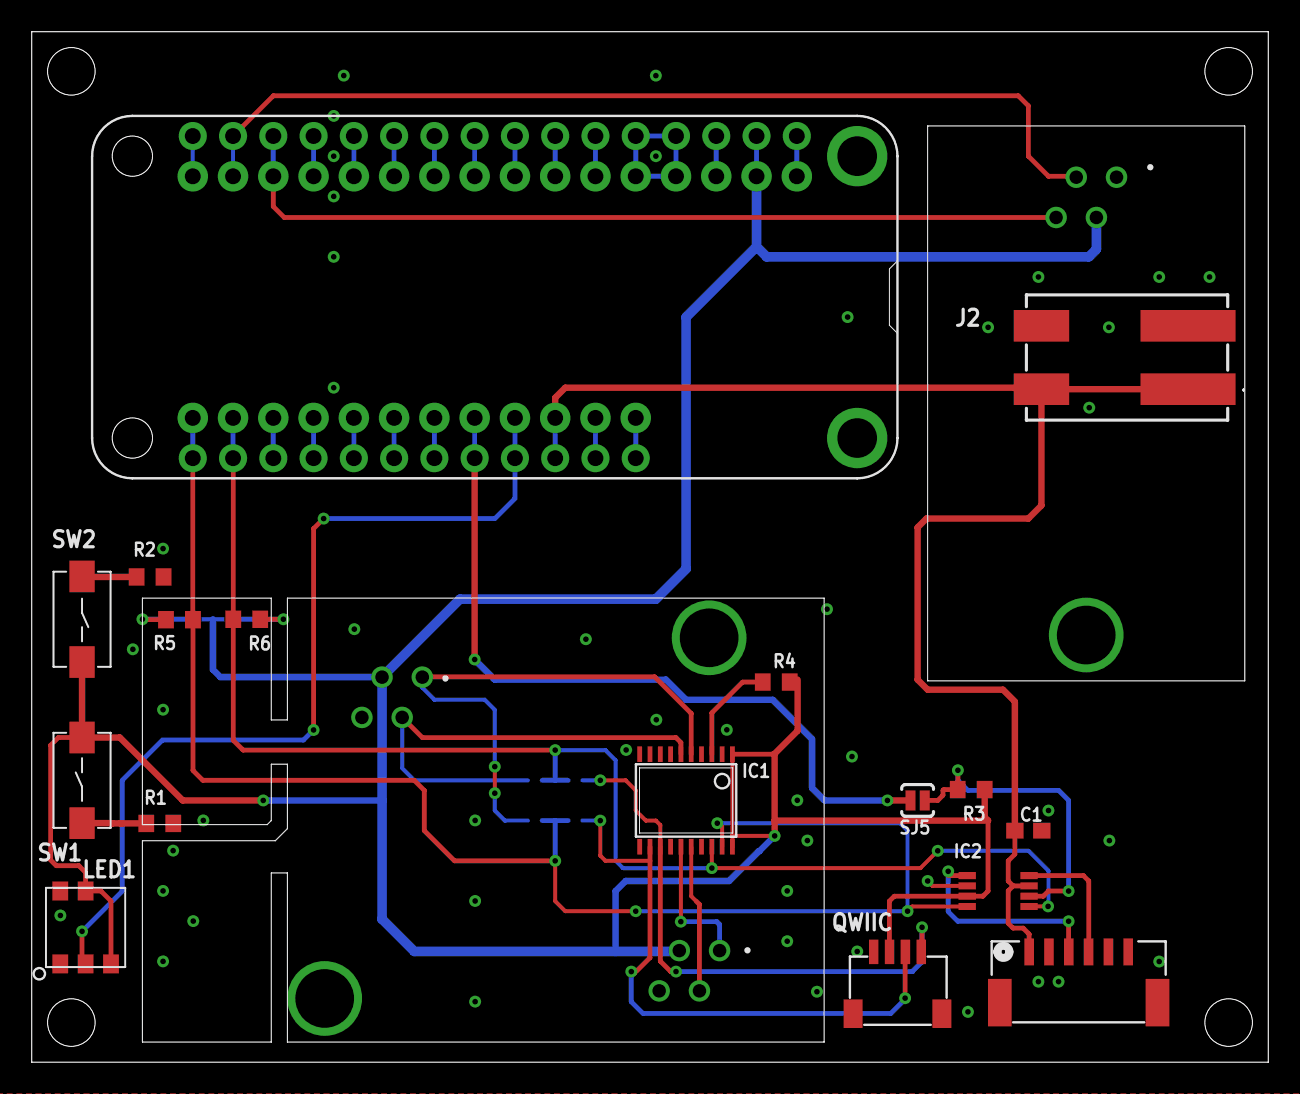
[picture p18: board feather.v4.brd from above]

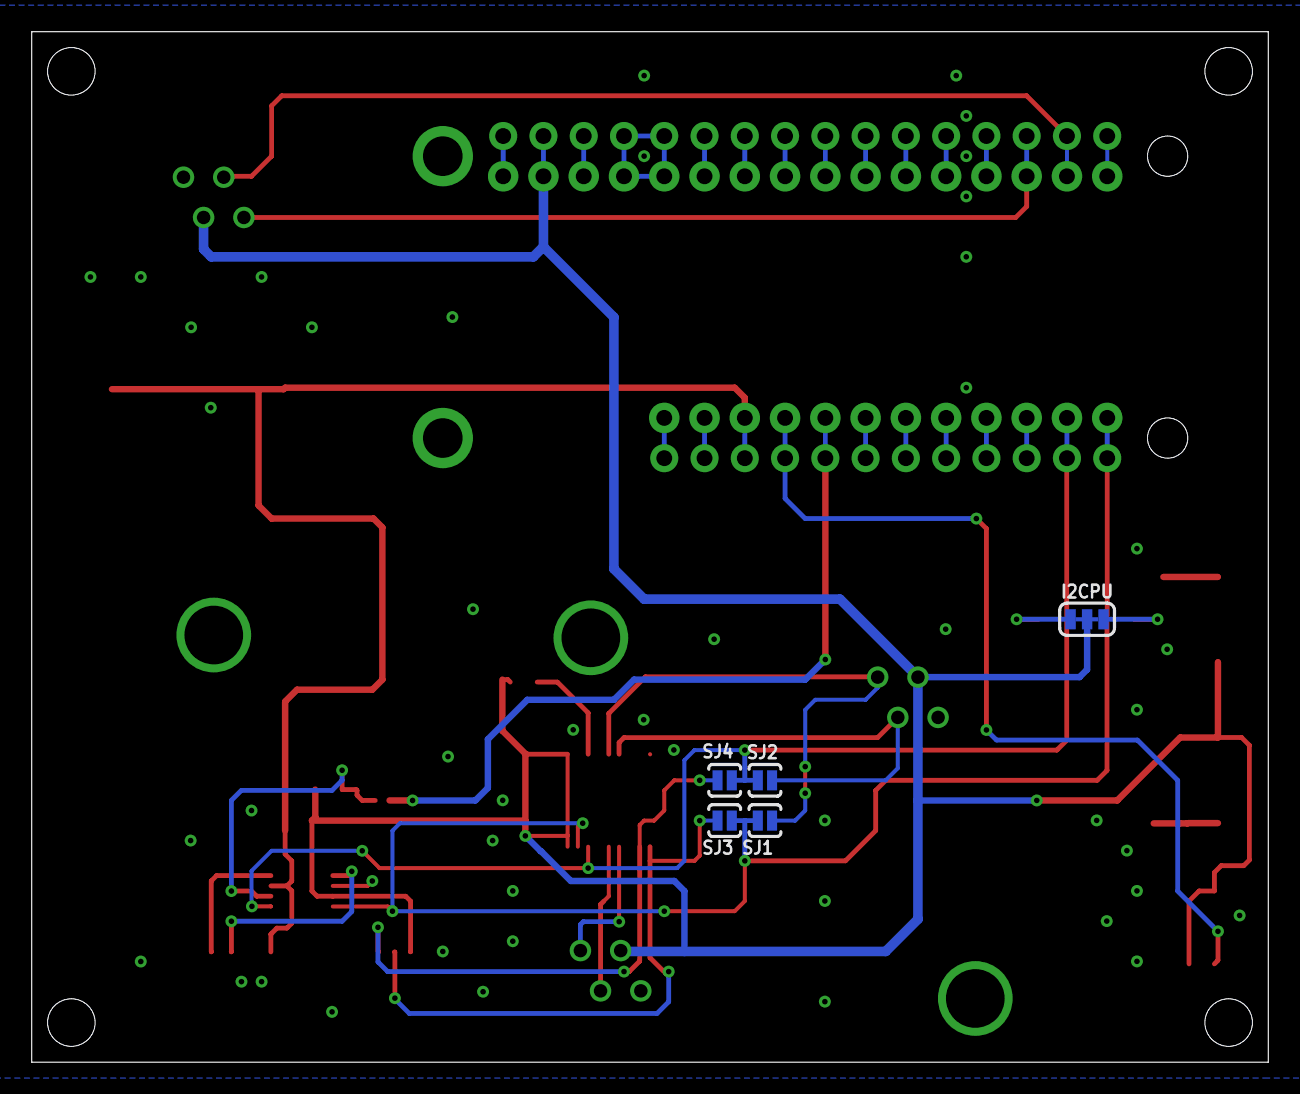
[picture p19: board feather.v4.brd from below]

Board: 2 copper layers, 78.0 x 65.0 mm, 26 parts (5 on the bottom side), 41 nets.
