ATM-HSW/CombiSensor/Hardware/BaseBoard-WaveshareESP32S2-LCD/waveshare.v4.brd

## EAGLE design Hardware/BaseBoard-WaveshareESP32S2-LCD/waveshare.v4.brd (2025-03-10)

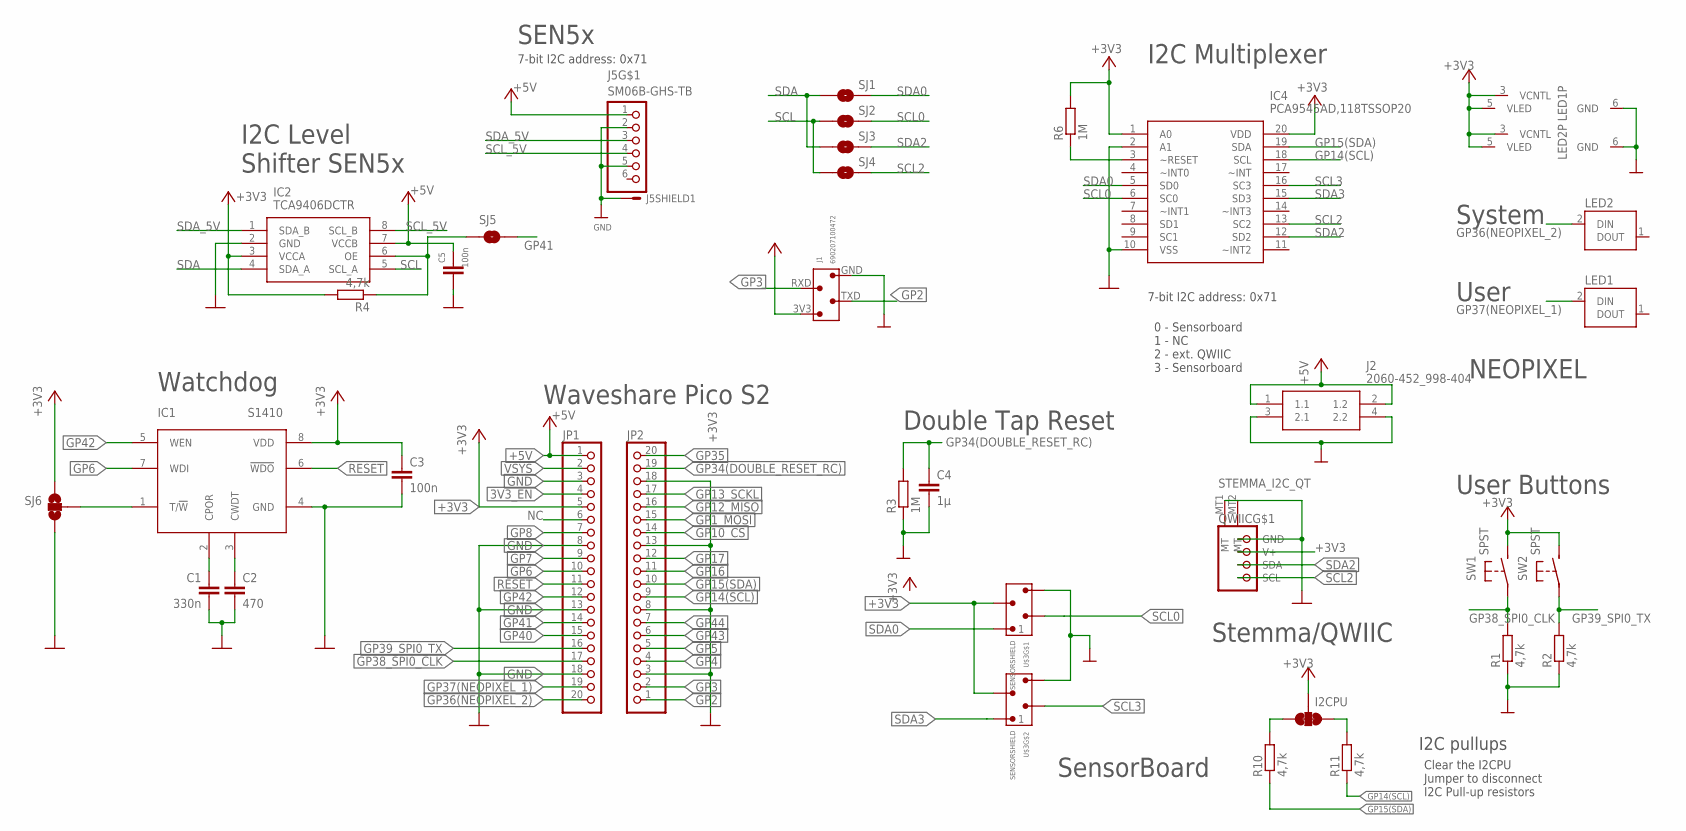
[picture p20: schematic waveshare.v4.sch]

Parts:
C1: 330n; C0603
C2: 470; C0603
C3, C5: 100n; C0603
C4: 1µ; C0603
I2CPU: I2C PU; SMT-JUMPER_3_2-NC_TRACE_SILK
IC1: S1410; MSOP08
IC2: TCA9406DCTR; SOP65P400X130-8N
IC4: PCA9545AD,118TSSOP20; TSSOP20
J1: 690207100472; LORASHIELD
J2: 2060-452_998-404; 2060452998404
J5: SM06B-GHS-TB; JST-PH-06-SMD
JP1, JP2: PINHD-1X20; 1X20
LED1, LED2: WS2812WS2812; WS2812
QWIIC: STEMMA_I2C_QT; JST_SH4
R1, R2, R4, R10, R11: 4,7k; R0603
R3, R6: 1M; R0603
SJ1, SJ2, SJ3, SJ4, SJ5: SOLDERJUMPERNO; SJ_2S-NO
SJ6: SOLDERJUMPER_2WAYTRACE1&2; SJ_3_TRACE1&2
SW1, SW2: SPST; DTSM-32S-B
U$3: SENSORSHIELD

Connections:
3V3_EN: JP1.4
+3V3: C3.1, I2CPU.2, IC1.8 (VDD), IC2.3 (VCCA), IC4.1 (A0), IC4.20 (VDD), J1.3V3 (4), JP1.5, LED1.3 (VCNTL), LED1.5 (VLED), LED2.3 (VCNTL), LED2.5 (VLED), QWIIC.2 (V+), R4.2, R6.2, SJ6.1, SW1.P$2 (S), SW2.P$2 (S), U$3.3V3_1 (3), U$3.3V3_2 (3)
+5V: C5.1, IC2.7 (VCCB), J2.1 (1.1), J2.2 (1.2), J5.1, JP1.1
GND: C1.2, C2.2, C3.2, C4.2, C5.2, IC1.4 (GND), IC2.2 (GND), IC4.2 (A1), IC4.10 (VSS), J1.GND (1), J2.3 (2.1), J2.4 (2.2), J5.2, J5.5, J5.7 (S), J5.8 (S), JP1.3, JP1.8, JP1.13, JP1.18, JP2.3, JP2.8, JP2.13, JP2.18, LED1.6 (GND), LED2.6 (GND), QWIIC.1 (GND), QWIIC.MT1 (MT), QWIIC.MT2 (MT), R1.1, R2.1, R3.1, SJ6.3, U$3.GND_1 (4), U$3.GND_2 (4)
GP1_MOSI: JP2.15
GP2: J1.TXD (3), JP2.1
GP3: J1.RXD (2), JP2.2
GP4: JP2.4
GP5: JP2.5
GP6: IC1.7 (WDI), JP1.10
GP7: JP1.9
GP8: JP1.7
GP10_CS: JP2.14
GP12_MISO: JP2.16
GP13_SCKL: JP2.17
GP14(SCL): IC4.18 (SCL), JP2.9, R11.1
GP15(SDA): IC4.19 (SDA), JP2.10, R10.1
GP16: JP2.11
GP17: JP2.12
GP34(DOUBLE_RESET_RC): C4.1, JP2.19, R3.2
GP35: JP2.20
GP36(NEOPIXEL_2): JP1.20, LED2.2 (DIN)
GP37(NEOPIXEL_1): JP1.19, LED1.2 (DIN)
GP38_SPI0_CLK: JP1.17, R1.2, SW1.P$1
GP39_SPI0_TX: JP1.16, R2.2, SW2.P$1
GP40: JP1.15
GP41: JP1.14, SJ5.2
GP42: IC1.5 (WEN), JP1.12
GP43: JP2.6
GP44: JP2.7
unnamed: IC2.6 (OE), R4.1, SJ5.1
unnamed: C1.1, IC1.2 (CPOR)
unnamed: C2.1, IC1.3 (CWDT)
unnamed: IC1.1 (T/!W), SJ6.2
unnamed: IC4.3 (~RESET), R6.1
unnamed: I2CPU.3, R10.2
unnamed: I2CPU.1, R11.2
NC: JP1.6
RESET: IC1.6 (!WDO), JP1.11
SCL: IC2.5 (SCL_A), SJ2.1, SJ4.1
SCL0: IC4.6 (SC0), SJ2.2, U$3.SCL0 (2)
SCL2: IC4.13 (SC2), QWIIC.4 (SCL), SJ4.2
SCL3: IC4.16 (SC3), U$3.SCL1 (2)
SCL_5V: IC2.8 (SCL_B), J5.4
SDA: IC2.4 (SDA_A), SJ1.1, SJ3.1
SDA0: IC4.5 (SD0), SJ1.2, U$3.SDA0 (1)
SDA2: IC4.12 (SD2), QWIIC.3 (SDA), SJ3.2
SDA3: IC4.15 (SD3), U$3.SDA1 (1)
SDA_5V: IC2.1 (SDA_B), J5.3
VSYS: JP1.2

Notes on the sheet:
SensorBoard
User
System
Double Tap Reset
User Buttons
Stemma/QWIIC
Watchdog
Waveshare Pico S2
7-bit I2C address: 0x71
I2C Multiplexer
0 - Sensorboard 1 - NC 2 - ext. QWIIC 3 - Sensorboard
NEOPIXEL
Clear the I2CPU Jumper to disconnect I2C Pull-up resistors
I2C pullups
SEN5x
I2C Level Shifter SEN5x

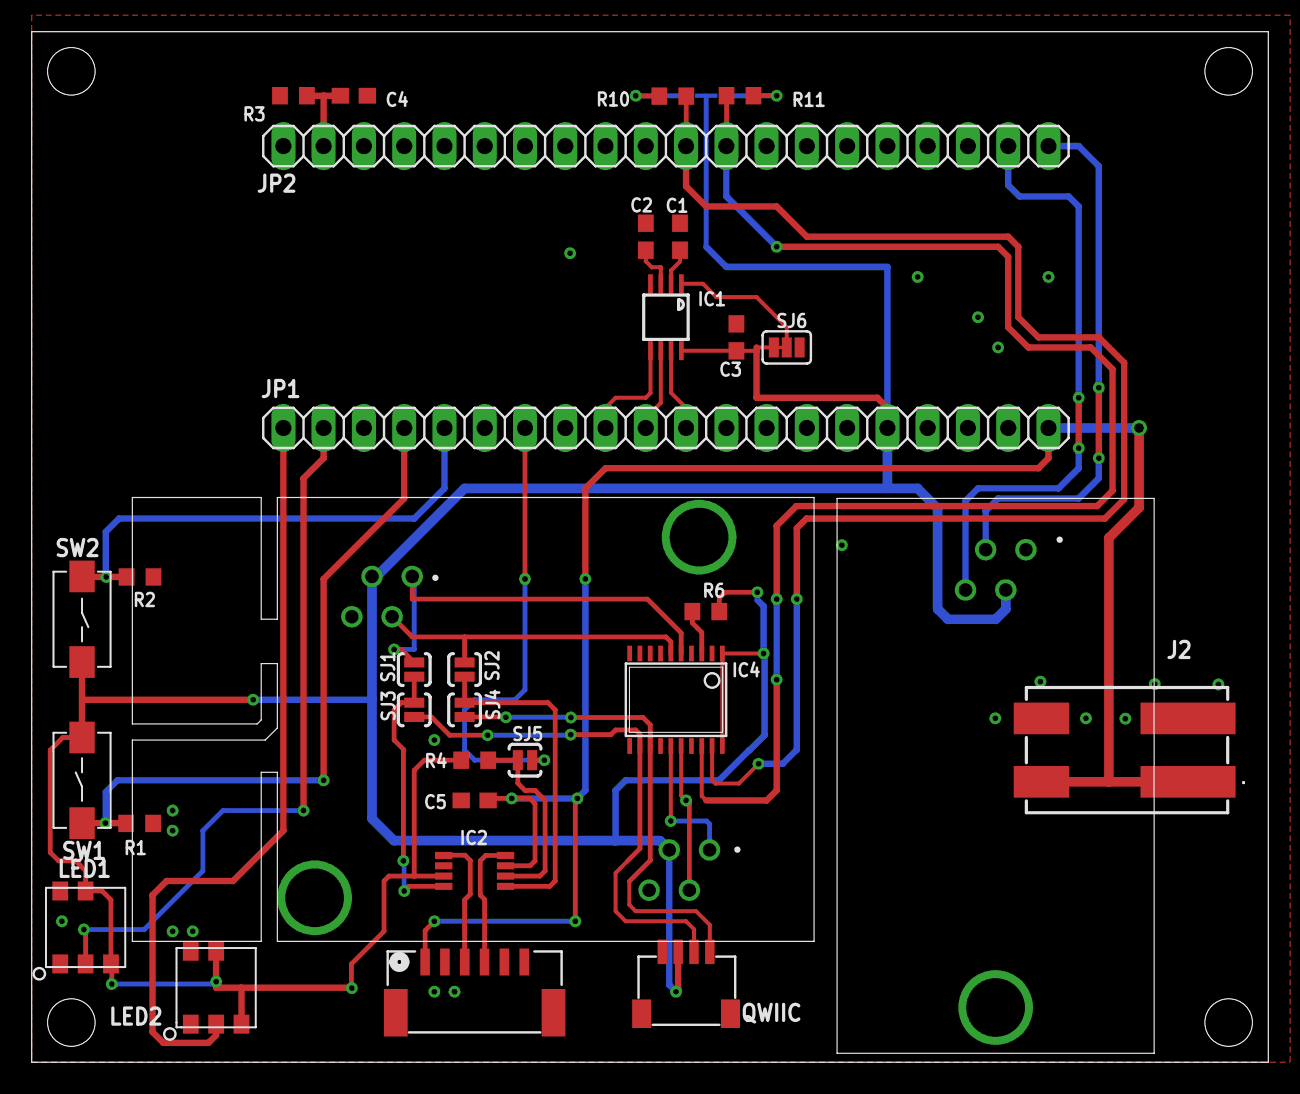
[picture p21: board waveshare.v4.brd from above]

Board: 2 copper layers, 78.0 x 65.0 mm, 33 parts (1 on the bottom side), 33 nets.
