ATM-HSW/CombiSensor/(commit log)

2025-03-10 adding hardware and esphome integration
    [QTPY.v3.brd, QTPY.v3.sch, SensorsOnly.v6.brd, SensorsOnly.v6.sch, SensorsOnly.v7.brd, SensorsOnly.v7.sch, feather.v4.brd, feather.v4.sch]
2025-03-10 adding circuitpython for waveshar dun qt py mcu boards
2025-05-25 SW Stand für SensorBoard+Sen5x, Sen6x und SDS011+BMP280
